saeedniko/LED_strip_stand_lamp/README.md

# LED_strip_stand_lamp

led_strip_stand_lamp

photo_5197630205005521579_y
