saeedniko/LED_strip_stand_lamp/hardware/USB_Controller.docx

Ein weiteres Problem war, dass die beiden LEDs am CP2102N nicht blinken, wenn über USB kommuniziert wird. Dies liegt an der Firmware des CP2102N. Falls Sie dies beheben wollen, benötigen Sie das Simplicity Studio. In diesem kann man eine Standardkonfiguration für den CP2102N laden und darin die beiden Pins für die LEDs konfigurieren (siehe Anhang) und anschließend flashen.

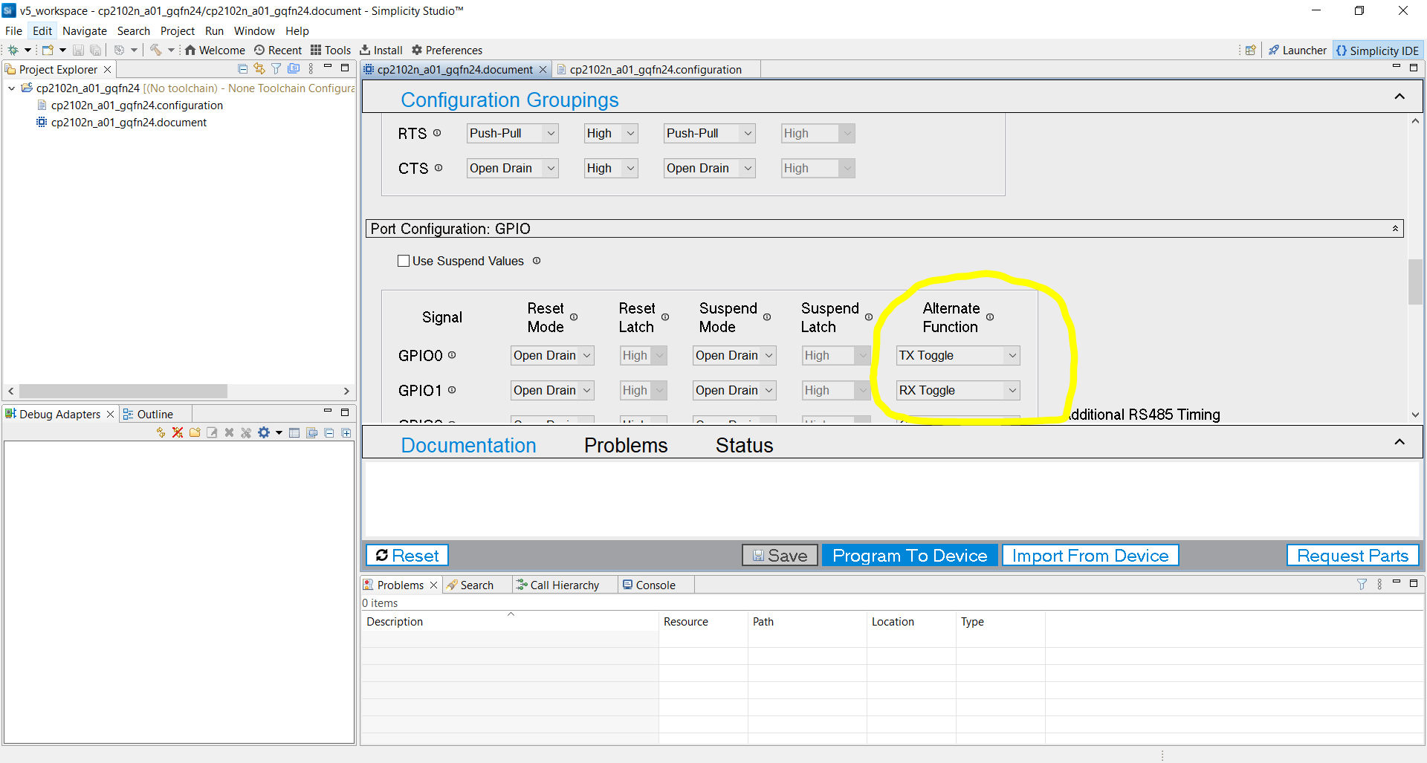
[picture p1: figure]
