saeedniko/LED_strip_stand_lamp/hardware/led_strip_stand_lamp/Lib-3D-Files/LTF4022T-1R8N-D--3DModel-STEP-56544.STEP

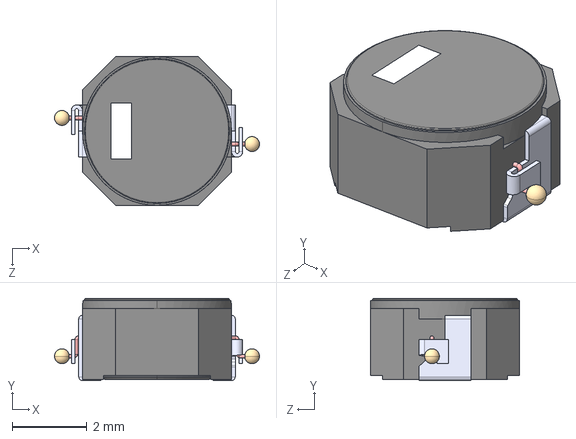
[picture p2: CAD file, 2024-06-03]
hardware/led_strip_stand_lamp/Lib-3D-Files/LTF4022T-1R8N-D--3DModel-STEP-56544.STEP
5.50 x 2.20 x 4.00 mm
