saeedniko/LED_strip_stand_lamp/hardware/led_strip_stand_lamp.pdf

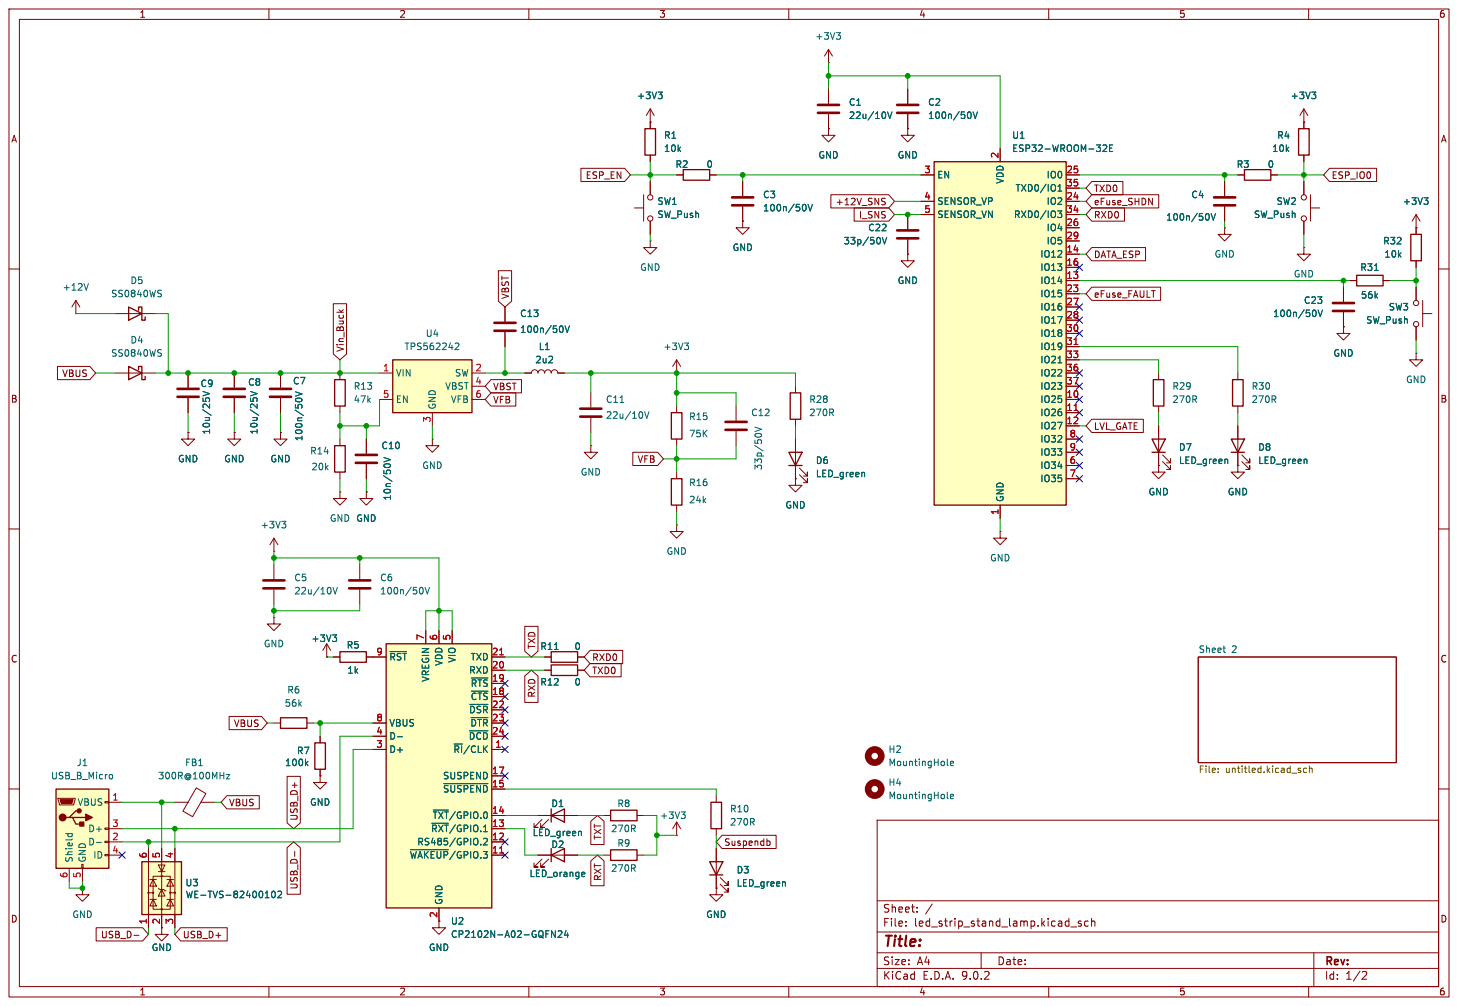
[picture p3: page 1]

5 TXD 21 RXD 20 ~{RTS} 19 ~{CTS} 18 ~{DSR} 22 ~{DTR} 23 ~{DCD} 24 ~{RI}/CLK1 SUSPEND 17 ~{SUSPEND}15 ~{TXT}/GPIO.014 ~{RXT}/GPIO.113 RS485/GPIO.2 12 ~{WAKEUP}/GPIO.311 R11 0 GND

5 TXD 21 RXD 20 ~{RTS} 19 ~{CTS} 18 ~{DSR} 22 ~{DTR} 23 ~{DCD} 24 ~{RI}/CLK1 SUSPEND 17 ~{SUSPEND}15 ~{TXT}/GPIO.014 ~{RXT}/GPIO.113 RS485/GPIO.2 12 ~{WAKEUP}/GPIO.311 U2 CP2102N-A02-GQFN24R11 0 GND

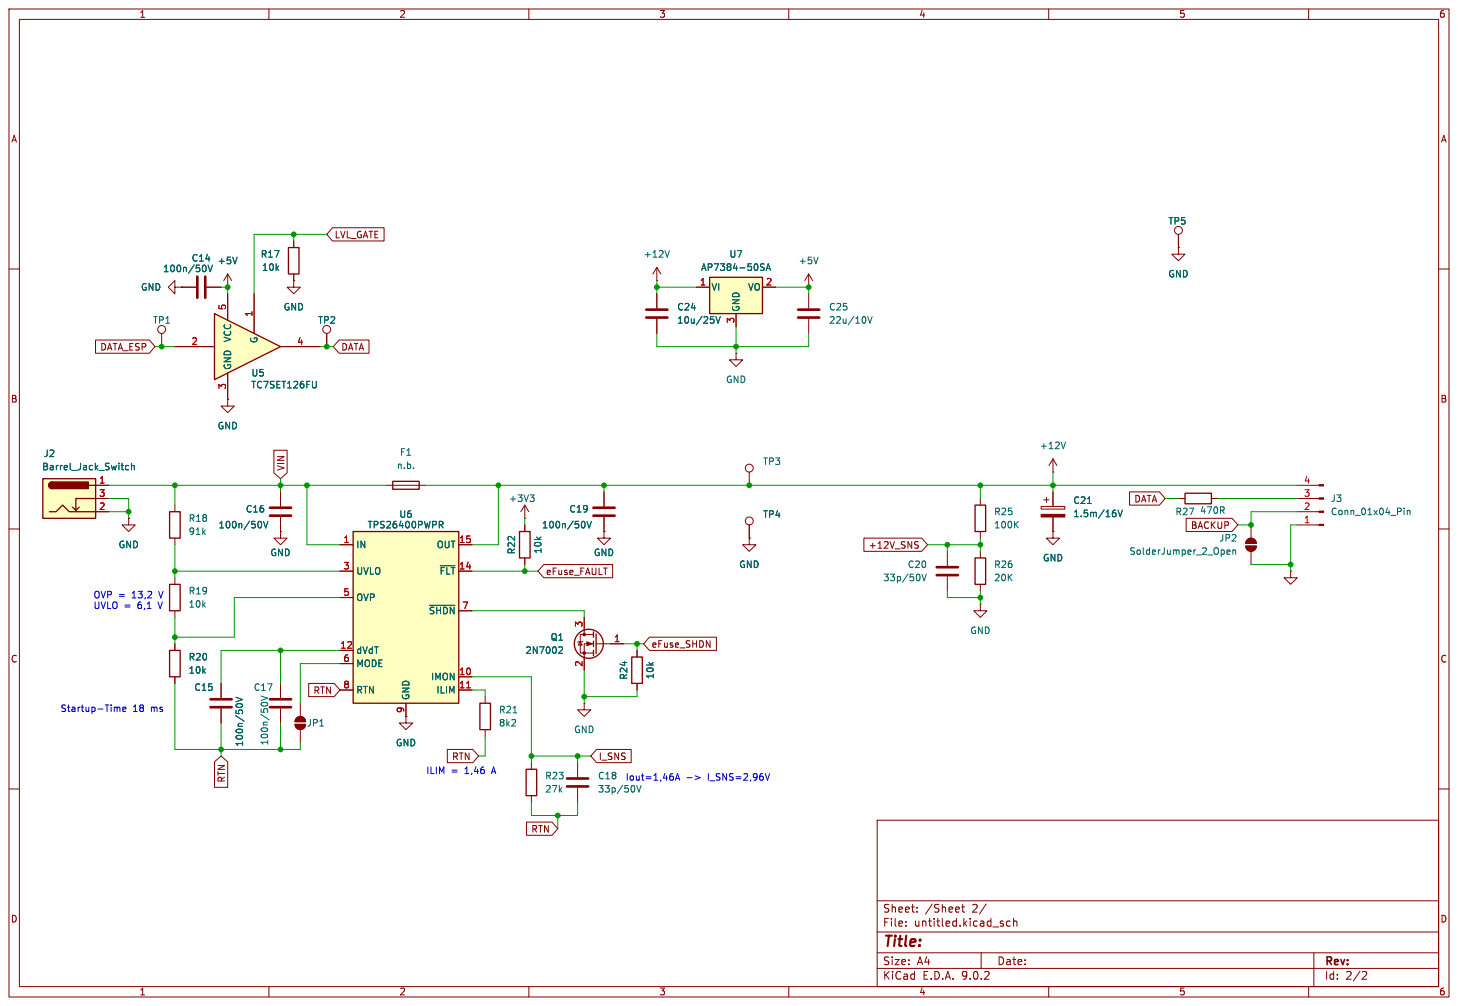
[picture p4: page 2]
