saeedniko/LED_strip_stand_lamp/hardware/led_strip_stand_lamp/led_strip_stand_lamp.kicad_pcb

## KiCad design hardware/led_strip_stand_lamp/led_strip_stand_lamp.kicad_pcb (2024-12-03)

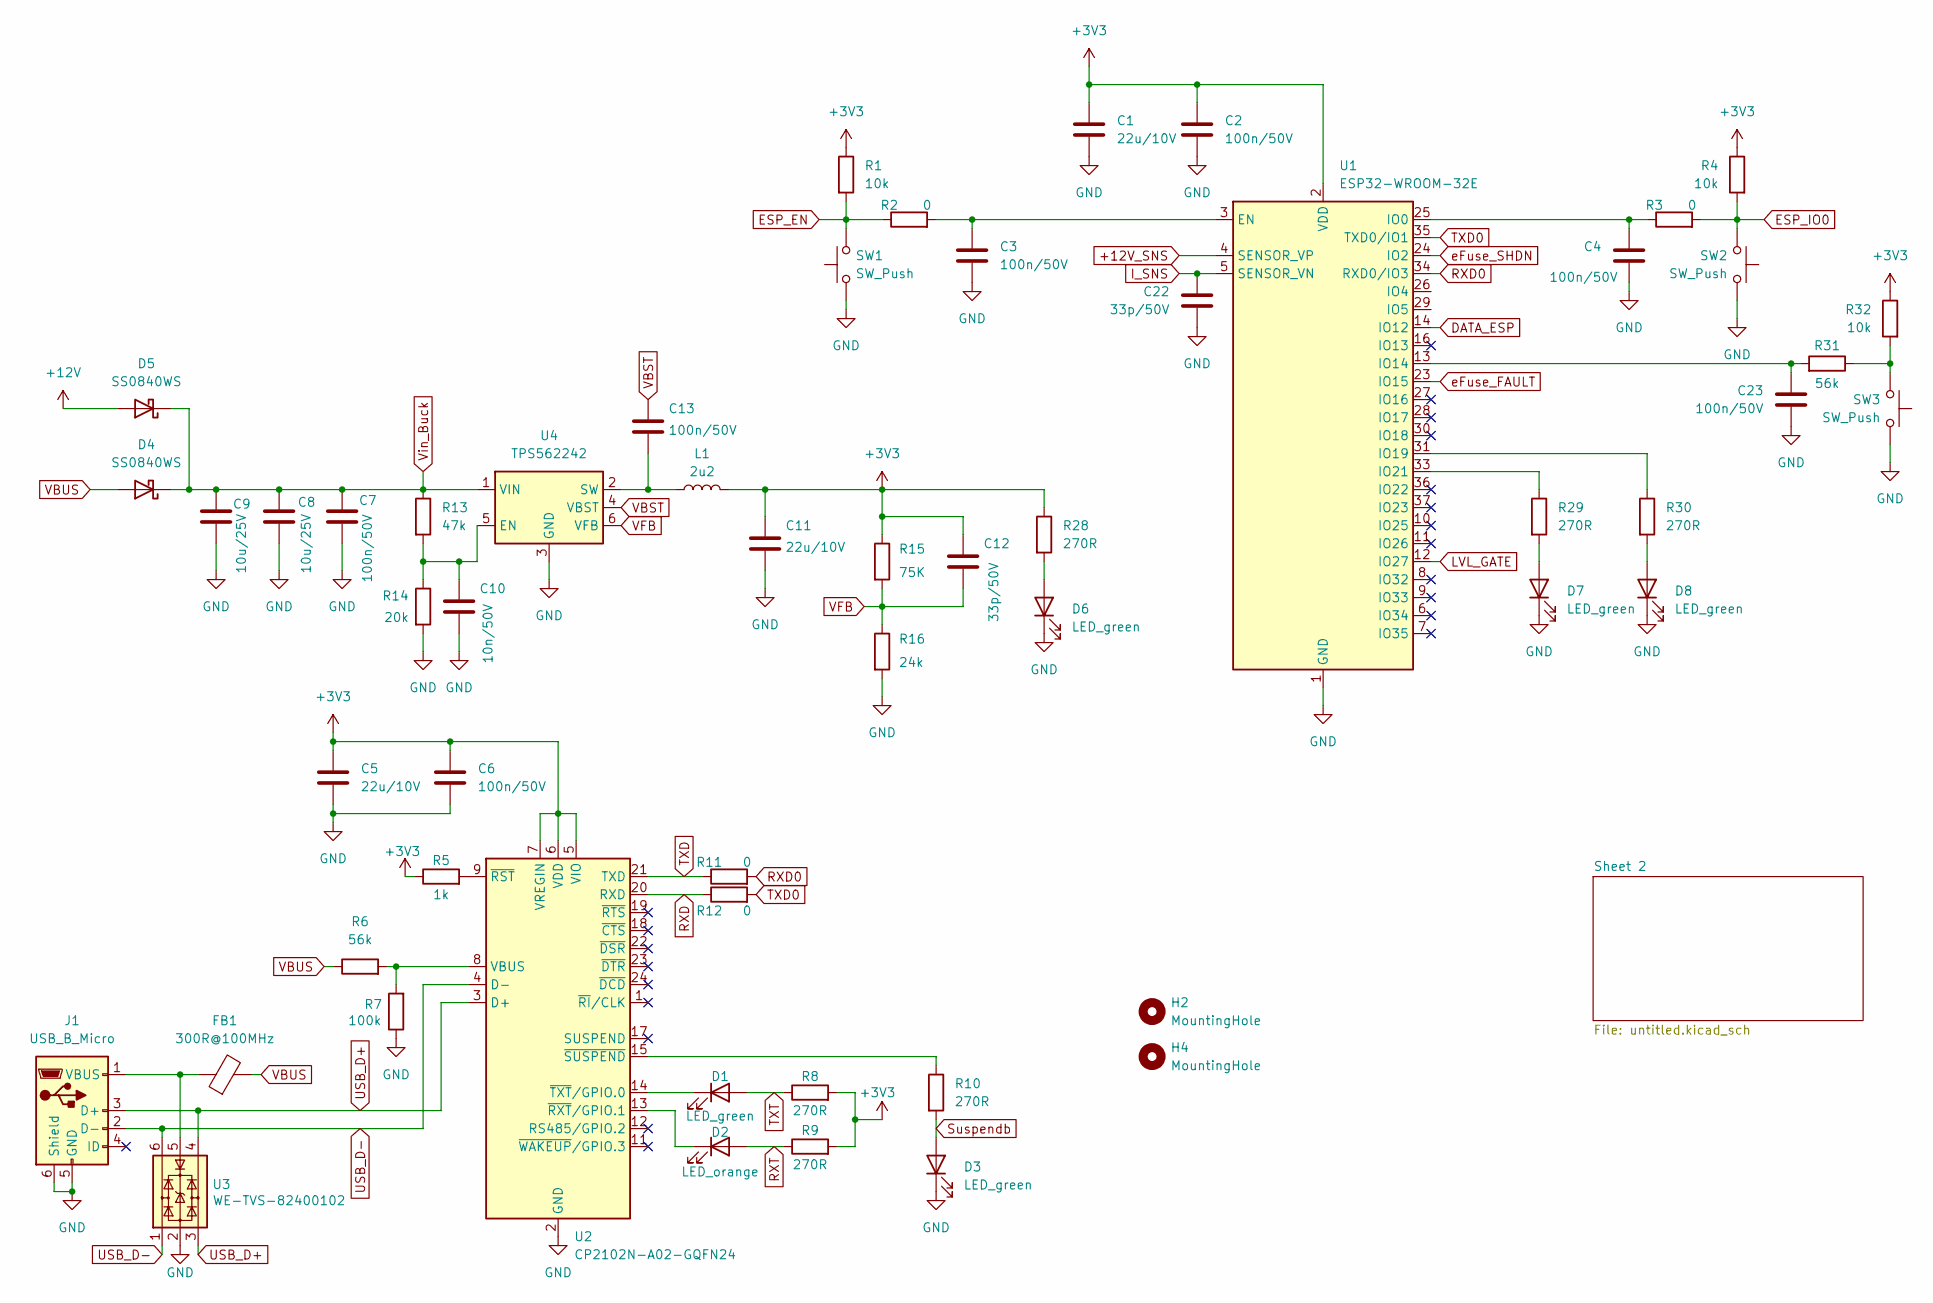
[picture p5: schematic led_strip_stand_lamp.kicad_sch]

Parts:
C1, C5, C11: 22u/10V; C_1206_3216Metric; MPN 81-GRM31CR71A226K15L
C2, C3, C4, C6, C7, C13, C23: 100n/50V; C_0603_1608Metric
C8, C9: 10u/25V; C_1206_3216Metric
C10: 10n/50V; C_1206_3216Metric
C12, C22: 33p/50V; C_0603_1608Metric
D1, D3, D6, D7, D8: LED_green; LED_0603_1608Metric; MPN 710-150060VS75000
D2: LED_orange; LED_0603_1608Metric; MPN 859-LTST-C190KFKT
D4, D5: SS0840WS; D_SOD-323F; MPN 241-SS0840WSR100001
FB1: 300R@100MHz; L_0603_1608Metric; MPN 710-742792641
H2, H4: MountingHole; MountingHole_3.2mm_M3
J1: USB_B_Micro; USB_Micro-B_Wuerth_629105150521; MPN 710-629105150521
L1: 2u2; L_Taiyo-Yuden_NR-24xx; MPN 963-NRH2410T2R2MN
R1, R4, R32: 10k; R_0603_1608Metric
R2, R3, R11, R12: 0; R_0603_1608Metric
R5: 1k; R_0603_1608Metric
R6, R31: 56k; R_0603_1608Metric
R7: 100k; R_0603_1608Metric
R8, R9, R10, R28, R29, R30: 270R; R_0603_1608Metric
R13: 47k; R_0603_1608Metric
R14: 20k; R_0603_1608Metric
R15: 75K; R_0603_1608Metric
R16: 24k; R_0603_1608Metric
SW1, SW2: SW_Push; SW_Push_1P1T_NO_CK_KMR2; MPN 611-KMR231NGLFS
SW3: SW_Push; SW_Tactile_SPST_Angled_PTS645Vx83-2LFS; MPN 611-PTS645VM832
U1: ESP32-WROOM-32E; ESP32-WROOM-32D
U2: CP2102N-A02-GQFN24; QFN-24-1EP_4x4mm_P0.5mm_EP2.6x2.6mm; MPN 634-CP2102NA02GQFN24
U3: WE-TVS-82400102; SOT-23-6; MPN 710-82400102
U4: TPS562242; SOT-563; MPN 595-TPS562242DRLR

Connections:
+3V3: C1.1, C2.1, C5.1, C6.1, C11.1, C12.1, L1.2, R1.1, R4.1, R5.1, R8.2, R9.2, R15.1, R28.1, R32.1, U1.2 (VDD), U2.5 (VIO), U2.6 (VDD), U2.7 (VREGIN); also elsewhere on the board
+12V: D5.2 (A); also elsewhere on the board
+12V_SNS: U1.4 (SENSOR_VP); also elsewhere on the board
DATA_ESP: U1.14 (IO12); also elsewhere on the board
ESP_EN: R1.2, R2.1, SW1.2
ESP_IO0: R3.2, R4.2, SW2.2
GND: C1.2, C2.2, C3.2, C4.2, C5.2, C6.2, C7.2, C8.2, C9.2, C10.2, C11.2, C22.2, C23.2, D3.1 (K), D6.1 (K), D7.1 (K), D8.1 (K), J1.5 (GND), J1.6 (Shield), R7.1, R14.2, R16.2, SW1.1, SW2.1, SW3.1, U1.1 (GND), U1.15 (GND), U1.38 (GND), U1.39 (GND), U2.2 (GND), U2.25 (GND), U3.2, U4.3 (GND); also elsewhere on the board
I_SNS: C22.1, U1.5 (SENSOR_VN); also elsewhere on the board
LVL_GATE: U1.12 (IO27); also elsewhere on the board
unnamed: D1.1 (K), U2.14 (~TXT/GPIO.0)
unnamed: D2.1 (K), U2.13 (~RXT/GPIO.1)
unnamed: D6.2 (A), R28.2
unnamed: D7.2 (A), R29.2
unnamed: D8.2 (A), R30.2
unnamed: FB1.1, J1.1 (VBUS), U3.5
unnamed: R31.1, R32.2, SW3.2
unnamed: C3.1, R2.2, U1.3 (EN)
unnamed: C4.1, R3.1, U1.25 (IO0)
unnamed: C23.1, R31.2, U1.13 (IO14)
unnamed: R30.1, U1.31 (IO19)
unnamed: R29.1, U1.33 (IO21)
unnamed: R6.2, R7.2, U2.8 (VBUS)
unnamed: R5.2, U2.9 (~RST)
unnamed: R10.1, U2.15 (~SUSPEND)
unnamed: C10.1, R13.2, R14.1, U4.5 (EN)
unnamed: C13.2, L1.1, U4.2 (SW)
RXD: R12.1, U2.20 (RXD)
RXD0: R11.2, U1.34 (RXD0/IO3)
RXT: D2.2 (A), R9.1
Suspendb: D3.2 (A), R10.2
TXD: R11.1, U2.21 (TXD)
TXD0: R12.2, U1.35 (TXD0/IO1)
TXT: D1.2 (A), R8.1
USB_D+: J1.3 (D+), U2.3 (D+), U3.3, U3.4
USB_D-: J1.2 (D-), U2.4 (D-), U3.1, U3.6
VBST: C13.1, U4.4 (VBST)
VBUS: D4.2 (A), FB1.2, R6.1
VFB: C12.2, R15.2, R16.1, U4.6 (VFB)
Vin_Buck: C7.1, C8.1, C9.1, D4.1 (K), D5.1 (K), R13.1, U4.1 (VIN)
eFuse_FAULT: U1.23 (IO15); also elsewhere on the board
eFuse_SHDN: U1.24 (IO2); also elsewhere on the board

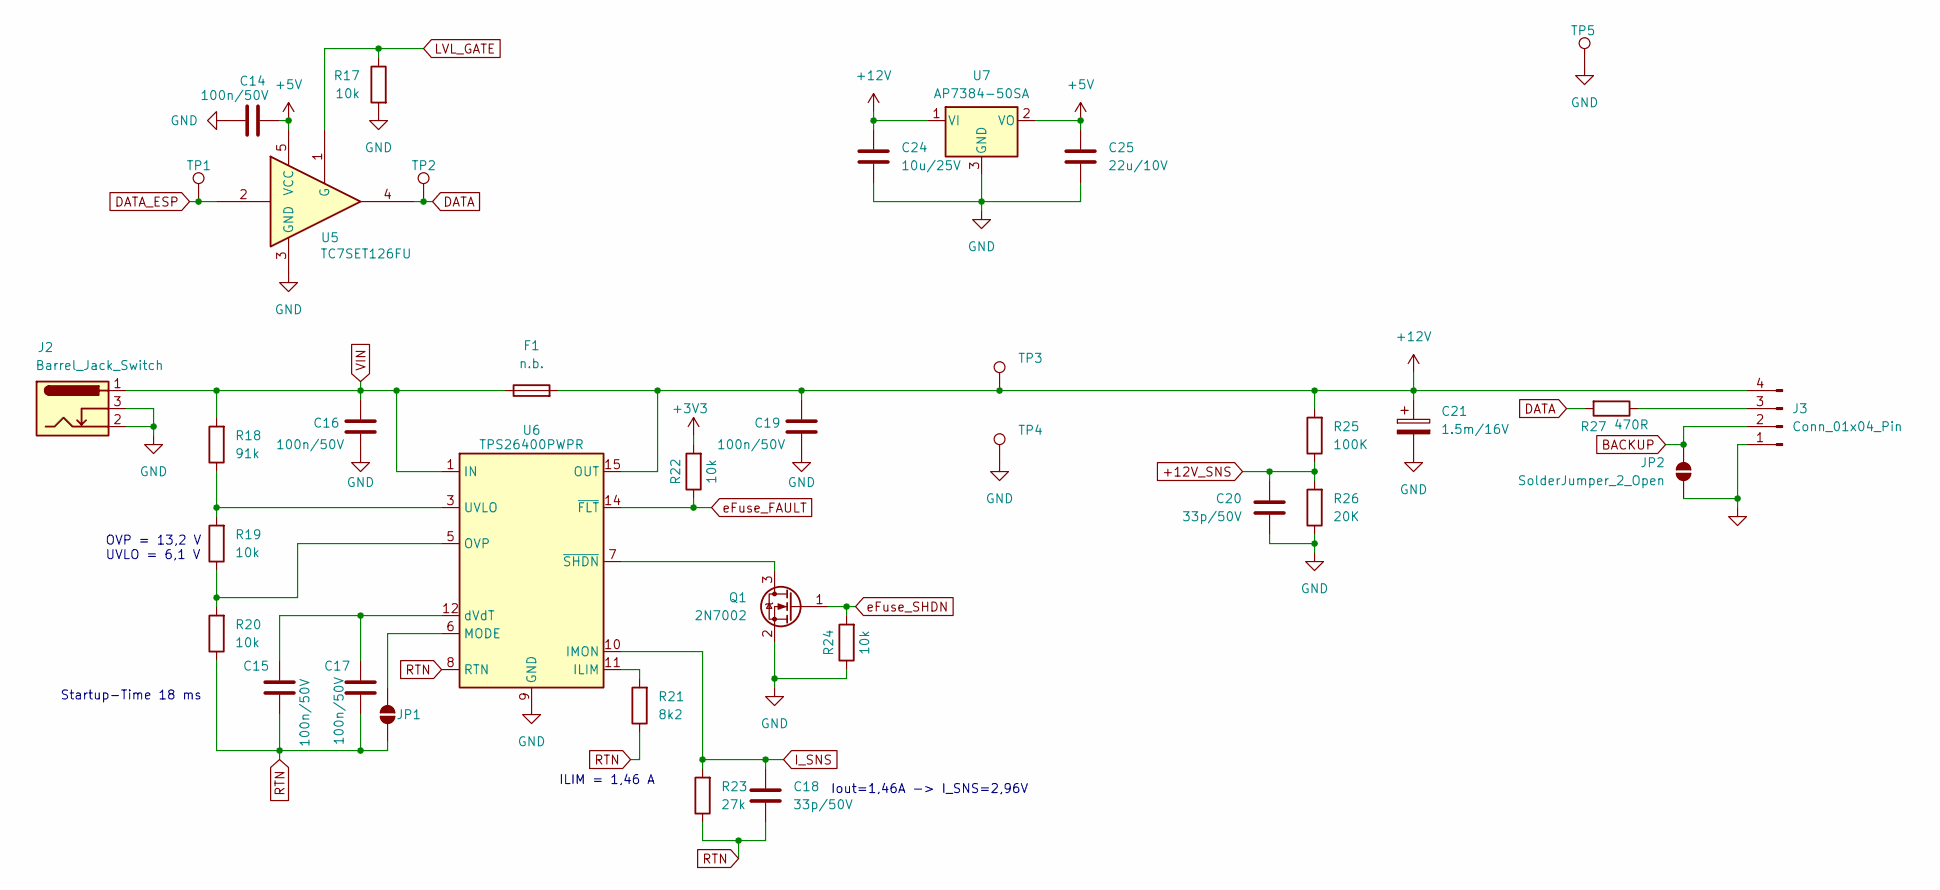
[picture p6: schematic untitled.kicad_sch]

Parts:
C14, C15, C16, C17, C19: 100n/50V; C_0603_1608Metric
C18, C20: 33p/50V; C_0603_1608Metric
C21: 1.5m/16V; CP_Radial_D10.0mm_P5.00mm; MPN 710-860020375019
C24: 10u/25V; C_1206_3216Metric
C25: 22u/10V; C_1206_3216Metric; MPN 81-GRM31CR71A226K15L
F1: n.b.; Fuse_1206_3216Metric; MPN 530-C1T3
J2: Barrel_Jack_Switch; BarrelJack_GCT_DCJ200-10-A_Horizontal; MPN 640-DCJ200-10-A-K1-K
J3: Conn_01x04_Pin; JST_XH_B4B-XH-A_1x04_P2.50mm_Vertical
JP1, JP2: SolderJumper_2_Open; SolderJumper-2_P1.3mm_Open_Pad1.0x1.5mm
Q1: 2N7002; SOT-23; MPN 637-2N7002
R17, R19, R20, R22, R24: 10k; R_0603_1608Metric
R18: 91k; R_0603_1608Metric
R21: 8k2; R_0603_1608Metric
R23: 27k; R_0603_1608Metric
R25: 100K; R_0603_1608Metric
R26: 20K; R_0603_1608Metric
R27: 470R; R_0603_1608Metric
TP1, TP2, TP3, TP4: TestPoint; TestPoint_Pad_D1.0mm
TP5: TestPoint; TestPoint_THTPad_D2.0mm_Drill1.0mm
U5: TC7SET126FU; SOT-353_SC-70-5; MPN 757-TC7SET126FULJCT
U6: TPS26400PWPR; HTSSOP-16-1EP_4.4x5mm_P0.65mm_EP3x3mm; MPN 595-TPS26400PWPR
U7: AP7384-50SA; SOT-23; MPN 621-AP7384-50SA-7

Connections:
+3V3: R22.2; also elsewhere on the board
+5V: C14.1, C25.1, U5.5 (VCC), U7.2 (VO)
+12V: C19.2, C21.1, C24.1, F1.2, J3.4, R25.2, TP3.1, U6.15 (OUT), U6.16 (OUT), U7.1 (VI); also elsewhere on the board
+12V_SNS: C20.1, R25.1, R26.2; also elsewhere on the board
BACKUP: J3.2, JP2.1 (A)
DATA: R27.2, TP2.1, U5.4
DATA_ESP: TP1.1, U5.2; also elsewhere on the board
GND: C14.2, C16.1, C19.1, C20.2, C21.2, C24.2, C25.2, J2.2, J2.3, J3.1, JP2.2 (B), Q1.2 (S), R17.2, R24.1, R26.1, TP4.1, TP5.1, U5.3 (GND), U6.9 (GND), U7.3 (GND); also elsewhere on the board
I_SNS: C18.1, R23.2, U6.10 (IMON); also elsewhere on the board
LVL_GATE: R17.1, U5.1 (G); also elsewhere on the board
unnamed: J3.3, R27.1
unnamed: JP1.1 (A), U6.6 (MODE)
unnamed: Q1.3 (D), U6.7 (~SHDN)
unnamed: R21.2, U6.11 (ILIM)
unnamed: R19.1, R20.2, U6.5 (OVP)
unnamed: R18.1, R19.2, U6.3 (UVLO)
unnamed: C15.2, C17.2, U6.12 (dVdT)
RTN: C15.1, C17.1, C18.2, JP1.2 (B), R20.1, R21.1, R23.1, U6.8 (RTN), U6.17 (RTN)
VIN: C16.2, F1.1, J2.1, R18.2, U6.1 (IN), U6.2 (IN)
eFuse_FAULT: R22.1, U6.14 (~FLT); also elsewhere on the board
eFuse_SHDN: Q1.1 (G), R24.2; also elsewhere on the board

Notes on the sheet:
Iout=1,46A -> I_SNS=2,96V
ILIM = 1,46 A
Startup-Time 18 ms
OVP = 13,2 V UVLO = 6,1 V

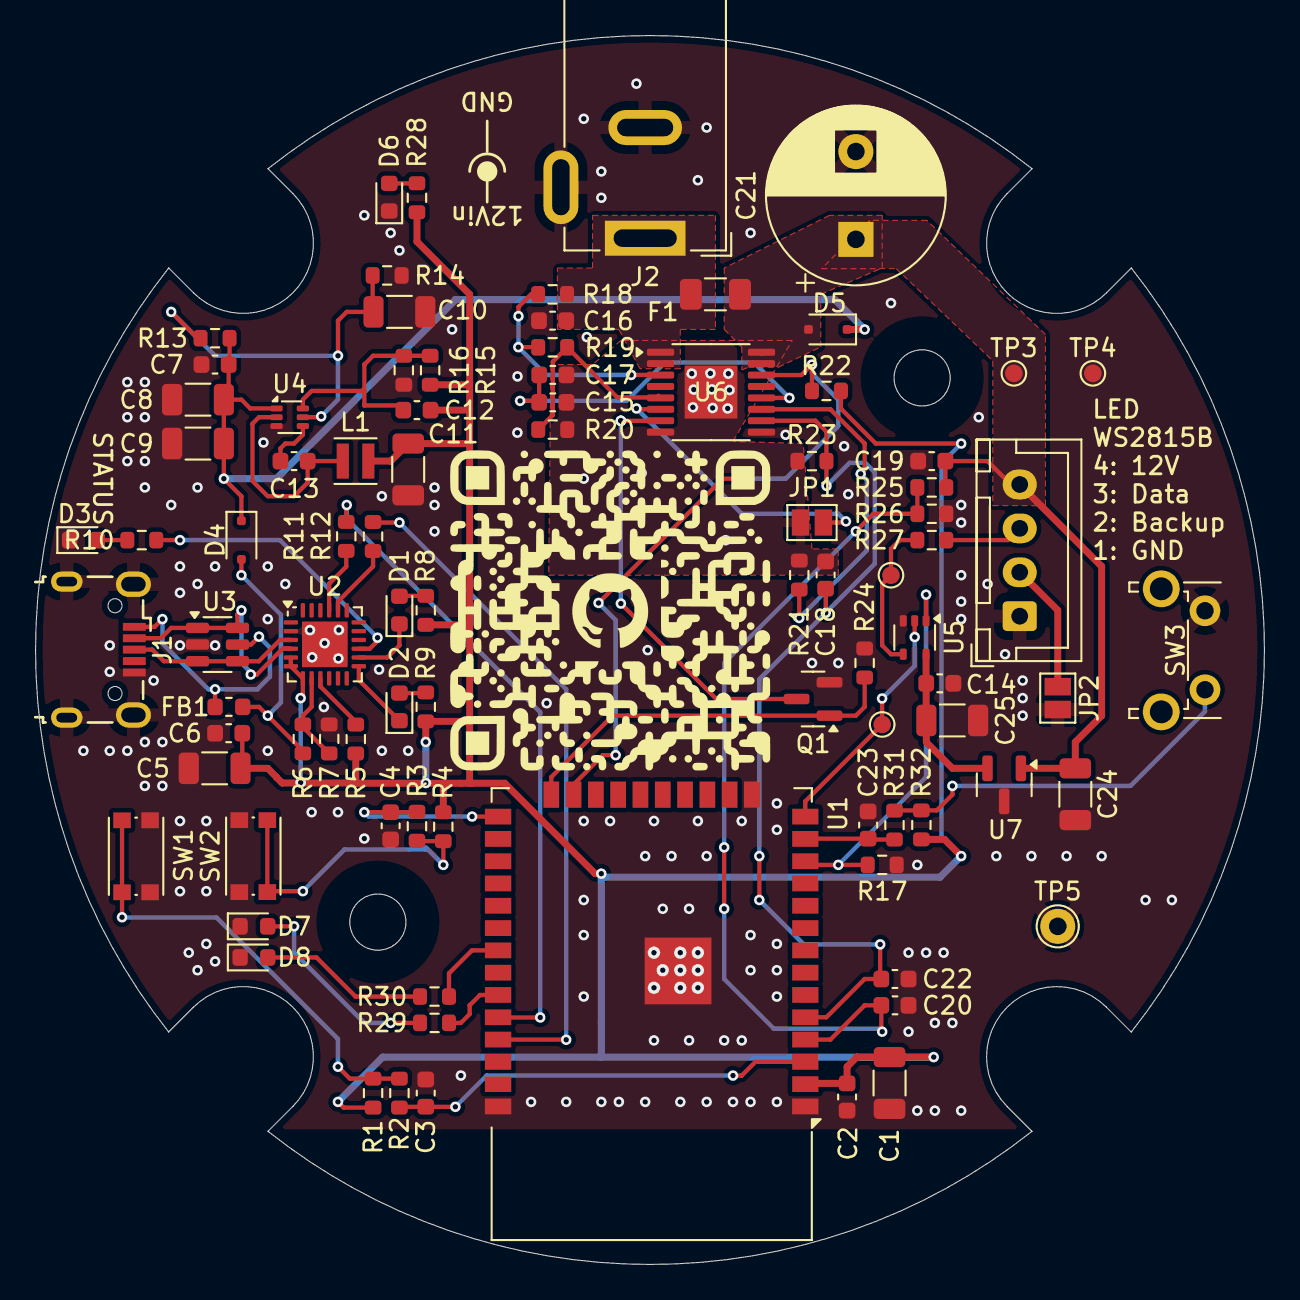
[picture p7: board led_strip_stand_lamp.kicad_pcb from above]

Board: 2 copper layers, 70.0 x 70.0 mm, 91 parts (0 on the bottom side), 53 nets.
