saeedniko/LED_strip_stand_lamp/(commit log)

2024-05-06 Added KiCad files
    [led_strip_stand_lamp.kicad_pcb, led_strip_stand_lamp.kicad_sch]
2024-05-06 first step in KiCad
    [led_strip_stand_lamp.kicad_pcb, led_strip_stand_lamp.kicad_sch]
2024-05-08 add USB
    [led_strip_stand_lamp.kicad_pcb, led_strip_stand_lamp.kicad_sch]
2024-05-09 add QR code
    [led_strip_stand_lamp.kicad_pcb]
2024-05-27 update PCB
    [led_strip_stand_lamp.kicad_pcb, led_strip_stand_lamp.kicad_sch]
2024-05-30 Restructure folders in repository
    [led_strip_stand_lamp.kicad_pcb, led_strip_stand_lamp.kicad_sch, untitled.kicad_sch]
2024-05-30 Update with last elements
    [led_strip_stand_lamp.kicad_pcb]
2024-05-30 arrange the components on the board
    [led_strip_stand_lamp.kicad_pcb]
2024-05-30 Resolve problem with 3.3V &3V3
    [led_strip_stand_lamp.kicad_pcb, led_strip_stand_lamp.kicad_sch]
2024-06-01 Update voltage and size
    [led_strip_stand_lamp.kicad_pcb, led_strip_stand_lamp.kicad_sch]
2024-06-01 Resolve problems with VIN & RTN
    [led_strip_stand_lamp.kicad_pcb, untitled.kicad_sch]
2024-06-03 Update thermal spoke width
    [led_strip_stand_lamp.kicad_pcb]
2024-06-03 Review the PCB
    [led_strip_stand_lamp.kicad_pcb]
2024-06-03 Review the GNDs
    [led_strip_stand_lamp.kicad_pcb]
2024-06-04 Update manual library
    [led_strip_stand_lamp.kicad_pcb]
2024-06-06 Update GND
    [led_strip_stand_lamp.kicad_pcb, untitled.kicad_sch]
2024-06-06 generate gerber and BOM
    [led_strip_stand_lamp-B_Cu.gbl, led_strip_stand_lamp-B_Cu.gbr, led_strip_stand_lamp-B_Mask.gbr, led_strip_stand_lamp-B_Mask.gbs, led_strip_stand_lamp-B_Paste.gbp, led_strip_stand_lamp-B_Paste.gbr, led_strip_stand_lamp-B_Silkscreen.gbo, led_strip_stand_lamp-B_Silkscreen.gbr]
2024-06-09 Update Resistors & remove extra files
    [led_strip_stand_lamp-B_Cu.gbl, led_strip_stand_lamp-B_Cu.gbr, led_strip_stand_lamp-B_Mask.gbr, led_strip_stand_lamp-B_Mask.gbs, led_strip_stand_lamp-B_Paste.gbp, led_strip_stand_lamp-B_Paste.gbr, led_strip_stand_lamp-B_Silkscreen.gbo, led_strip_stand_lamp-B_Silkscreen.gbr]
2024-07-02 Fix errors
    [led_strip_stand_lamp-B_Cu.gbr, led_strip_stand_lamp-B_Mask.gbr, led_strip_stand_lamp-Edge_Cuts.gbr, led_strip_stand_lamp-F_Cu.gbr, led_strip_stand_lamp-F_Mask.gbr, led_strip_stand_lamp-F_Paste.gbr, led_strip_stand_lamp-F_Silkscreen.gbr, led_strip_stand_lamp-NPTH.drl]
2024-12-03 Change resistor R2 and R3 to solve problem with IO0 and EN-Pin
    [led_strip_stand_lamp.kicad_pcb, led_strip_stand_lamp.kicad_sch, untitled.kicad_sch]
2025-04-20 Update LED configuration and pins
2025-09-13 End os version 1.0
    [led_strip_stand_lamp.kicad_sch, untitled.kicad_sch]
2026-02-01 Refactor LED strip code: reduce LED count, remove unused sensor code, and simplify setup
2026-02-01 Start with ESP32
